Ekkehard-Schulze/precision-temperature-logger/hardware_sensor_breakout_boards/TMP117-WSON-package-Sensor-PCBs/Readme

PCBs for a TMP117 sensor
A nice alternative is the Adafruit 4821 board. See: https://www.adafruit.com/product/4821
