Ekkehard-Schulze/precision-temperature-logger/settings.txt for SD-card/settings.txt

/ This config file is for the TMP117 Adafruit Feather 32u4 Adalogger
/ Copy this file onto the logger's SD-card
/ This file requires UNIX line ends (LF). 
/ The first character of this line ('/') specifies a line as a comment.
/ A comment does not influence the logger.
/
/
/ logging interval in seconds, a multiple of this must be 3600 , 300 seconds is the default of the software. 
/
interval=300
/
/
/
/interval=6
/ use 6 seconds for test purposes, e.g. for a new sensors and setups
/ 
/ TMP117 sensor configuration
/ --------------------------------------
/ up to four TMP117 can be used on the I2C-bus
/ each sensor must be configured (wired) for its own individual I2C bus address
/ four different addresses are availabe: 0x48, 0x49, 0x4A, and 0x4B
/ these generate column names TMP1, TMP2, TMP3, TMP4
/
/ charging
/----------
/ Charge logger using a Mico-USB cable with  switch in ON position. 
/ Remove micro-SD card, if you do not want to log data during charging.
/ The yellow LED indicates charging activity. It goes dark when charging finished.
/ Charge current is 400 mA, maximal required charge time is 8 hours
/ Attention: 400 mA charge current is NOT the default charge current 
/ of the Adafruit Feather 32u4 Adalogger #2795 board!
/ You have to change R0 to 2k2 (resistor package SMD 0805) to set 
/ 400 mA charge current
