Ekkehard-Schulze/precision-temperature-logger/hardware_sensor_breakout_boards/TMP117-WSON-package-Sensor-PCBs/2022_0597_Platine_0x49_V001_SCH.PDF

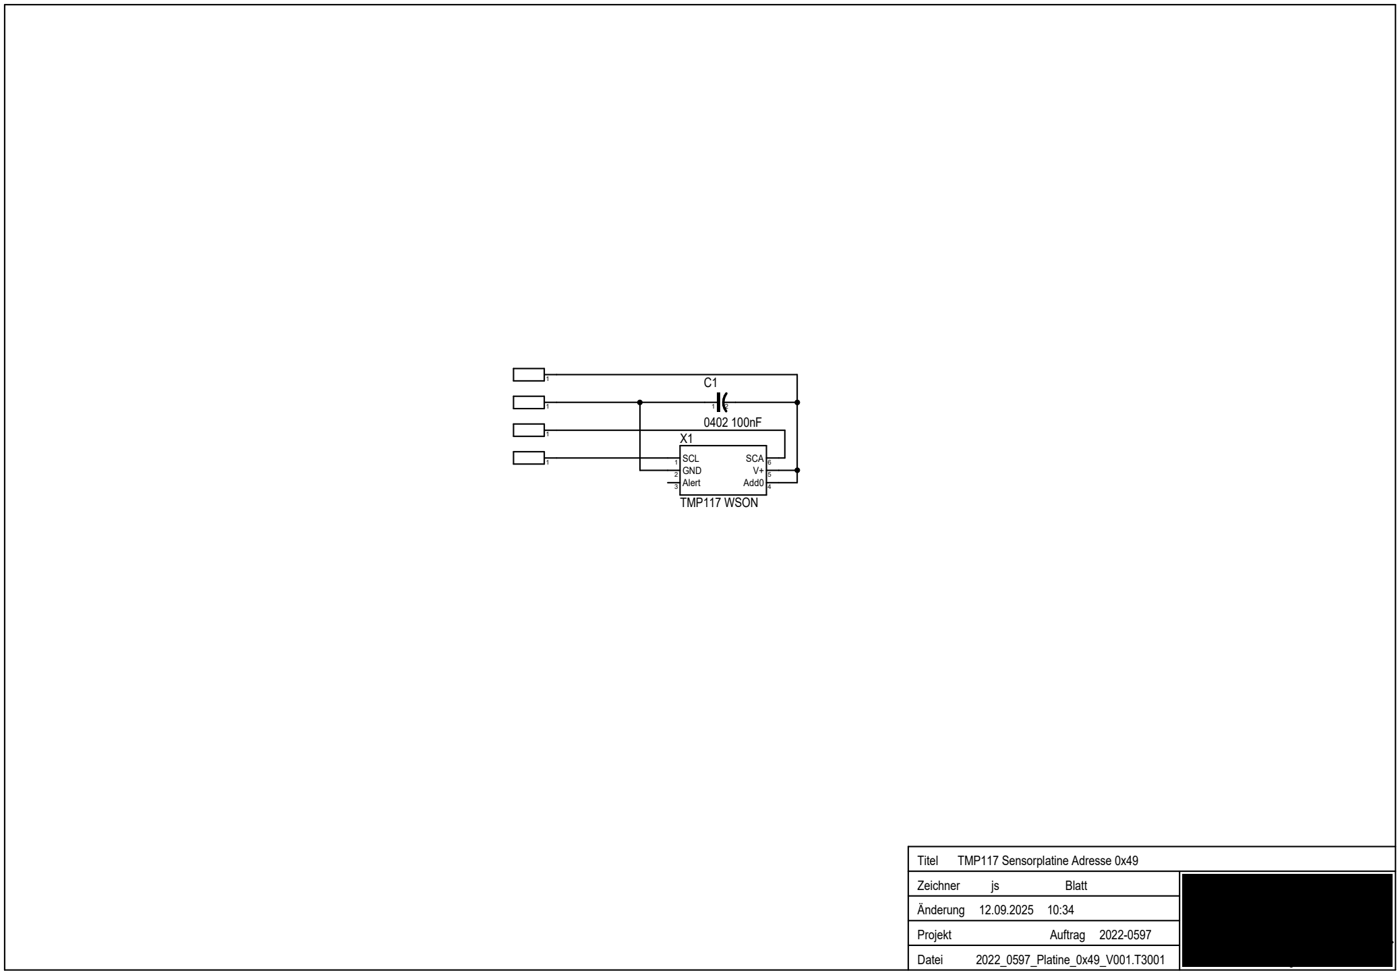
[picture p8: figure]
TMP117 Sensorplatine Adresse 0x49; 2022_0597_Platine_0x49_V001.T3001; Änderung; Projekt; Titel; Zeichner; Blatt; Datei; Institut für Biologie II/III; Albert-Ludwigs-Universität Freiburg; ATArbeitsgruppe Technik; Add0; 5 SCA; Alert ²; GND; 1 SCL TMP117 WSON

Auftrag | Schänzlestr. 1 79104 Freiburg Technischer Bereich
