Ekkehard-Schulze/precision-temperature-logger/firmware_temperature_logger_TMP117/DS3231_Set_Time.ino/README.md

Arduino firmware to set the time of the DS3231 real time clock
============================================================

Choose one of three methods:
-------

1. To set the clock to the compile time of the script, compile and upload the code in 
the Arduino IDE; the microcontroller then restarts and updates the DS3231 RTC time. 
The RTC will be a little (e.g. 1 second)
behind the real time.

2. To set a different time than the PC's system time, temporarily change
the PC's system time to the intended time, compile and run the firmware, and then change the PC's
system time back to the original. This approach can be used to set the clock for example to UTC.

3. Alternatively, to set the clock to a fixed time, uncomment line 33 and edit the time specified.
Compile and upload the software, then use an accurate reference clock to reset or startup
the microcontroller at this specific time.

Make sure the microcontroller is not started for a second time with this firmware, this 
would set a time which is behind the real time. Instead,
after setting the DS3231 RTC time, immediately upload the 
application firmware to the microcontroller.
