Ekkehard-Schulze/precision-temperature-logger/hardware_logger/Picture_2025-09-08_08h16_51.jpg

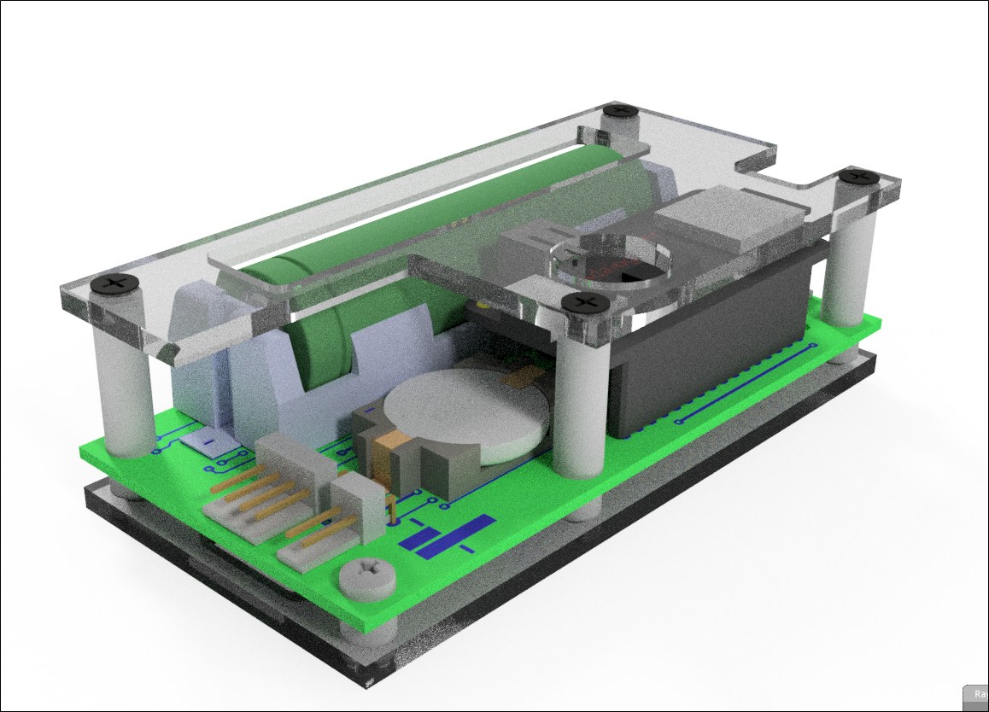
hardware_logger/Picture_2025-09-08_08h16_51.jpg
