Ekkehard-Schulze/precision-temperature-logger/hardware_logger/Picture_2025-09-08_13h42_57.png

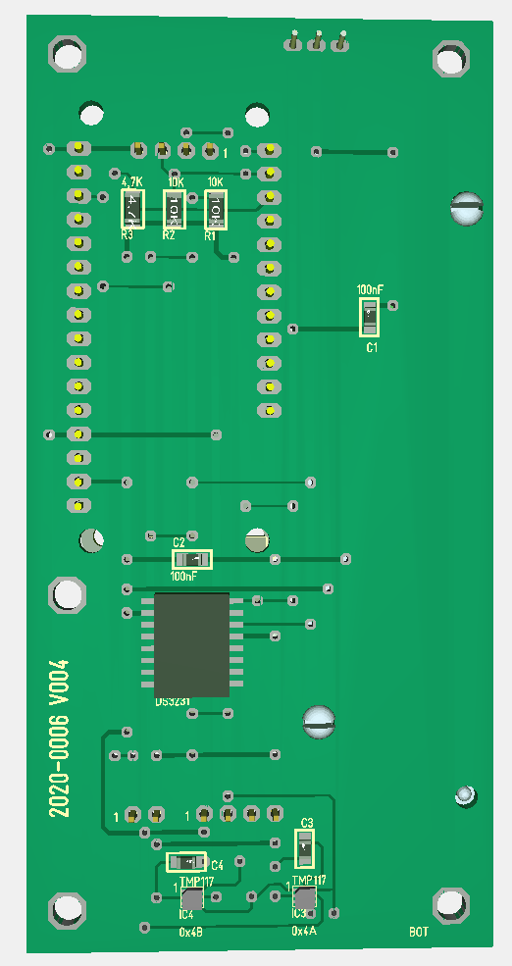
hardware_logger/Picture_2025-09-08_13h42_57.png
