Ekkehard-Schulze/precision-temperature-logger/hardware_sensor_breakout_boards/TMP117-WSON-package-Sensor-PCBs/2025-09-04_08h20_58.png

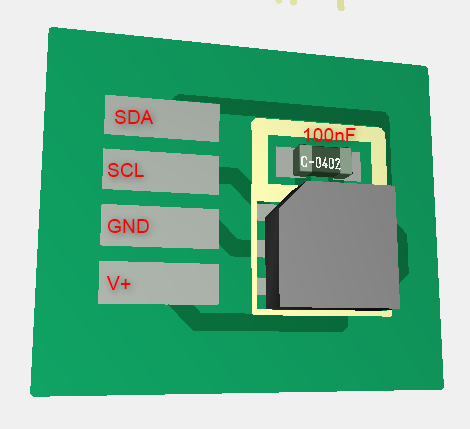
hardware_sensor_breakout_boards/TMP117-WSON-package-Sensor-PCBs/2025-09-04_08h20_58.png
