Ekkehard-Schulze/precision-temperature-logger/hardware_logger/PartsList.ods

Pos. | Beschreiburg | Hersteller | Herstellernr. | Distributor | Bestellnr. | Stück
1 | ADAFRUIT INDUSTRIESMCU, Feather 32u4 Adalogger, MCU, Entwicklungsboard, ATmega32u4 | Adafruit | 2795 | Distrelec | 301-39-090 | 1
2 | 1043 - Batteriehalter SMD 1 x 18650, Keystone | Keystone | 1043 | Distrelec | 169-14-431 | 1
3 | RND 305-00034 - Batteriehalter 1x CR2032, 20mm, SMD, RND Components | RND | RND 305-00034 | Distrelec | 301-65-960 | 1
4 | RND 305-00006 - Lithium-Knopfzellen-Batterie CR2032 5er-Pack, RND Power | RND | RND 305-00006 | Distrelec | 301-01-420 | 1
5 | Intenso MSDHC4G Micro SD Karte | Intenso |  | Reichelt | Intenso MSDHC4G | 1
6 | KEYSTONE 1042 Batteriehalter für 1 18650 | Keystone | 1042 | Reichelt | KEYSTONE 1042 | 1
7 | PSS 254/2W Printstecker, Einzelstecker, gewinkelt, 2-polig |  |  | Reichelt | PSS 254/2W | 1
8 | PSS 254/4W Printstecker, Einzelstecker, gewinkelt, 4-polig |  |  | Reichelt | PSS 254/4W | 2
9 | GP 18650 2,6 Industriezelle, Li-Ion, 18650, 3,7 V, 2600 mAh, Button Top |  |  | Reichelt | GP 18650 | 1
10 | CR 2032 Lithium-Knopfzelle, 3 V, 210 mAh, 20,0x3,2 mm Lithium-Knopfzelle, 3 V, 210 mAh, 20,0x3,2 mm FREI CR2032 |  |  | Reichelt | CR 2032 | 1
11 | ADAFRUIT INDUSTRIESMCU, Feather 32u4 Adalogger, MCU, Entwicklungsboard, ATmega32u4 | Adafruit | 2795 | RS | 124-5523 | 1
12 | KNITTER-SWITCH MMP 1010 D-1 Schiebeschalter, Einpoliger Ein/Aus-Schalter (SPST), 300 mA @ 24 V ac/dc, 500 mA @ 12 V dc | Knitter | MMP 1010 D-1 | RS | 913-9065 | 1
13 | Echtzeituhr (RTC) Batteriepufferung, Kalender, Serial-Bus Bus, SOIC 16-Pin | Maxim | DS3231SN# | RS | 732-7582 | 1
14 | TMP117AIDRVR | Texas Instruments |  | RS | 252-8571 | 2
15 | Platine 90x45 mit Stencil |  |  |  |  | 1
16 | Widerstand 1206 2 K |  |  |  |  | 2
17 | Widerstand 1206 4,7 K |  |  |  |  | 1
18 | Kondensatot 100nF 1206 |  |  |  |  | 4
19 | Buchsenleiste | Fischer Elektronik | BL1.36 G | Reichelt | FIS BL1 36 G | 2
