Ekkehard-Schulze/precision-temperature-logger/hardware_logger/LaserCut_BasePlate.pdf

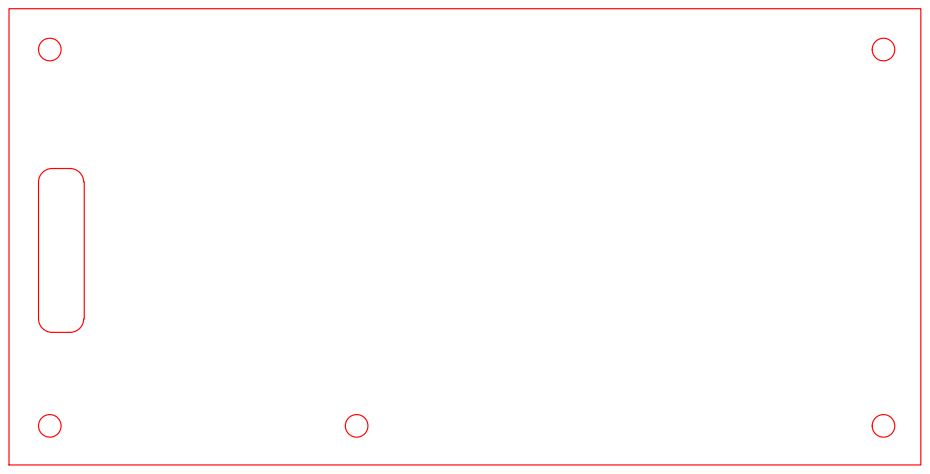
[picture p13: page 1]
3mm Acrylic glass
