Ekkehard-Schulze/precision-temperature-logger/hardware_logger/LaserCutUpperPart.pdf

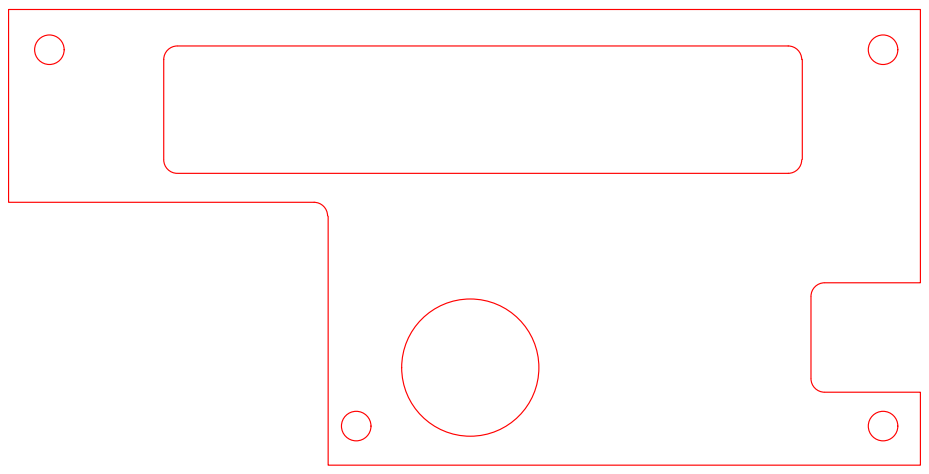
[picture p14: page 1]
3mm Acrylic glass
