Ekkehard-Schulze/precision-temperature-logger/hardware_logger/Circuit_Diagram_2020_0007_V004.PDF

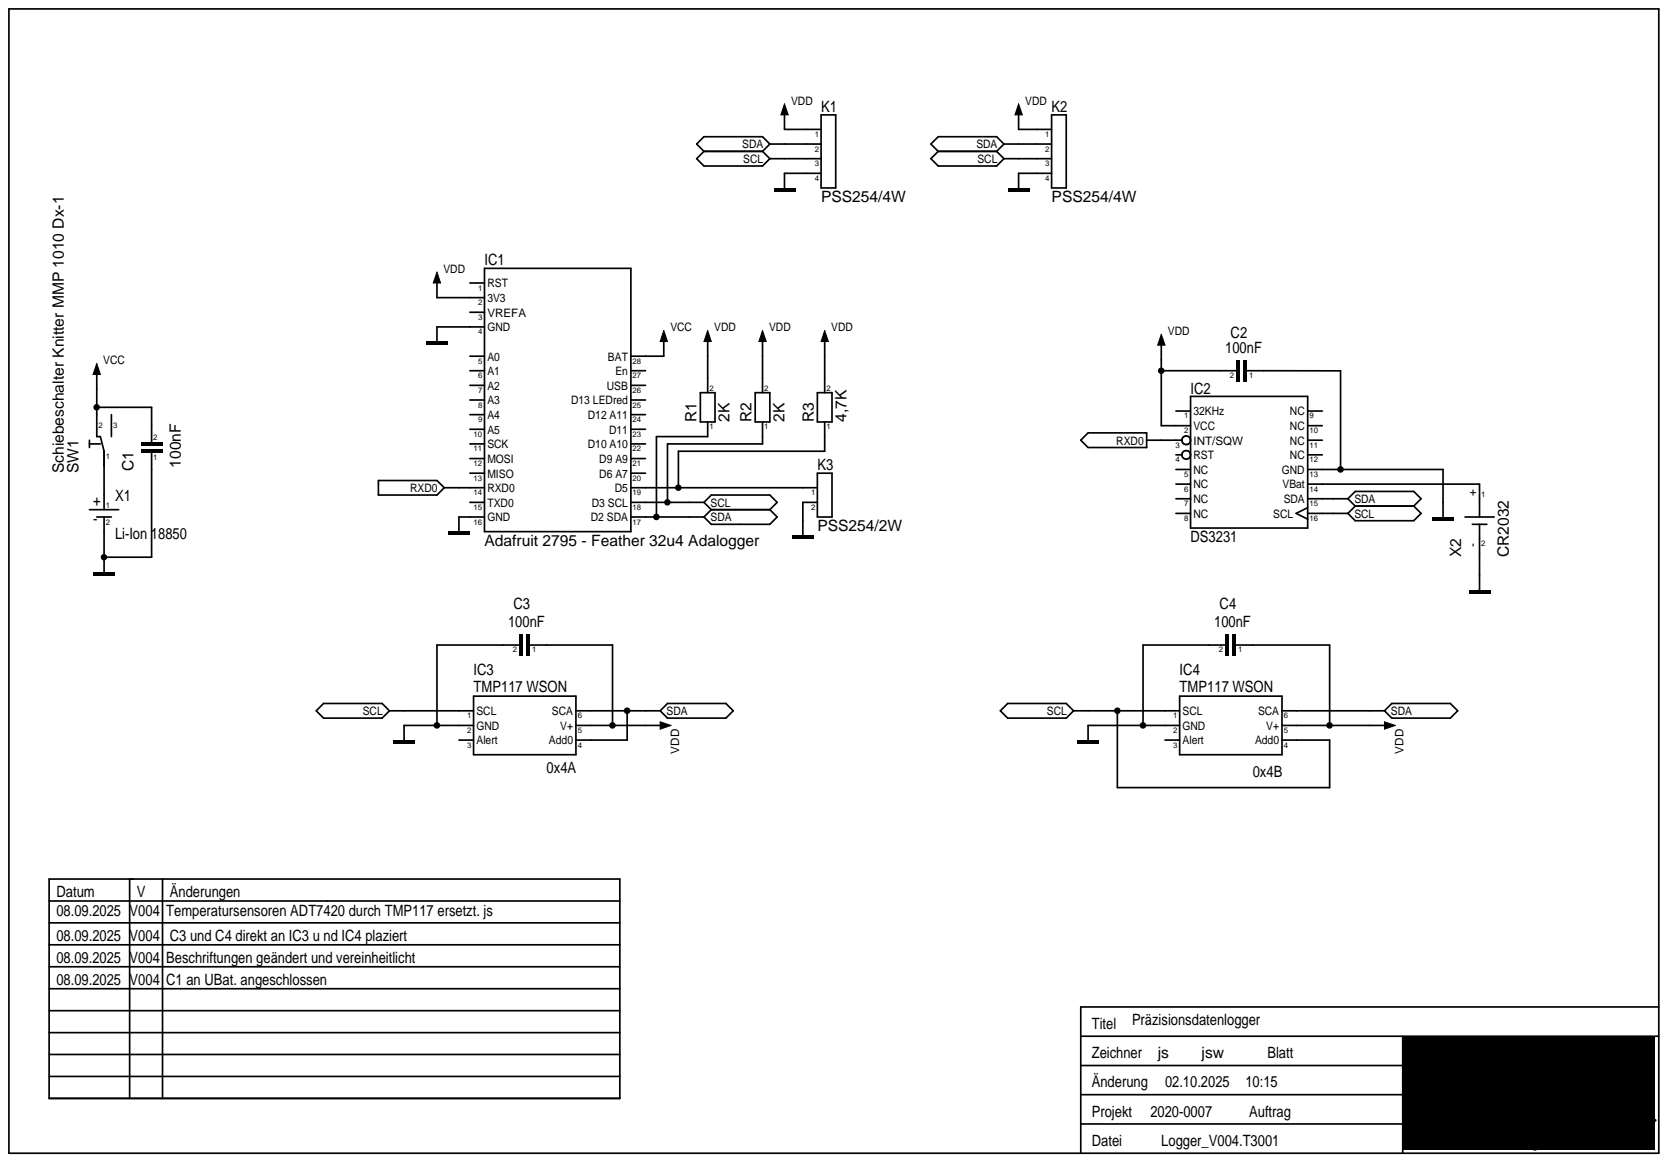
[picture p15: page 1]

Schiebeschalter Knitter MMP 1010 Dx-1

Datum | V | Änderungen
08.09.2025 | V004 | Temperatursensoren ADT7420 durch TMP117 ersetzt. js
08.09.2025 | V004 | C3 und C4 direkt an IC3 u nd IC4 plaziert
08.09.2025 | V004 | Beschriftungen geändert und vereinheitlicht
08.09.2025 | V004 | C1 an UBat. angeschlossen

Albert-Ludwigs-Universität Freiburg

Institut für Biologie II/III
Technischer Bereich
