Ekkehard-Schulze/precision-temperature-logger/hardware_logger/Drawing_01-01-2020-0007-BasePlate.pdf

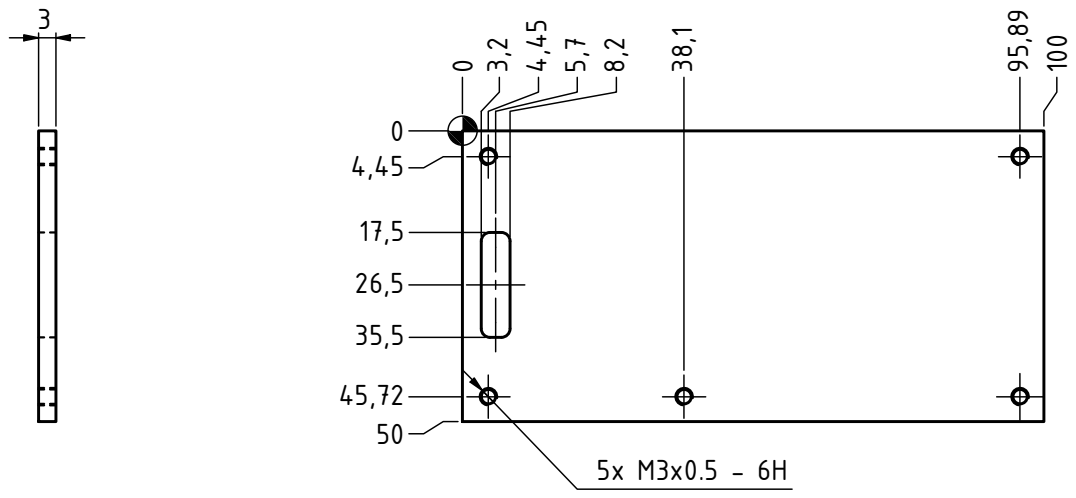
[picture p16: page 1]
