Ekkehard-Schulze/precision-temperature-logger/hardware_logger/Drawing_01-02-2020-0007-UpperPart.pdf

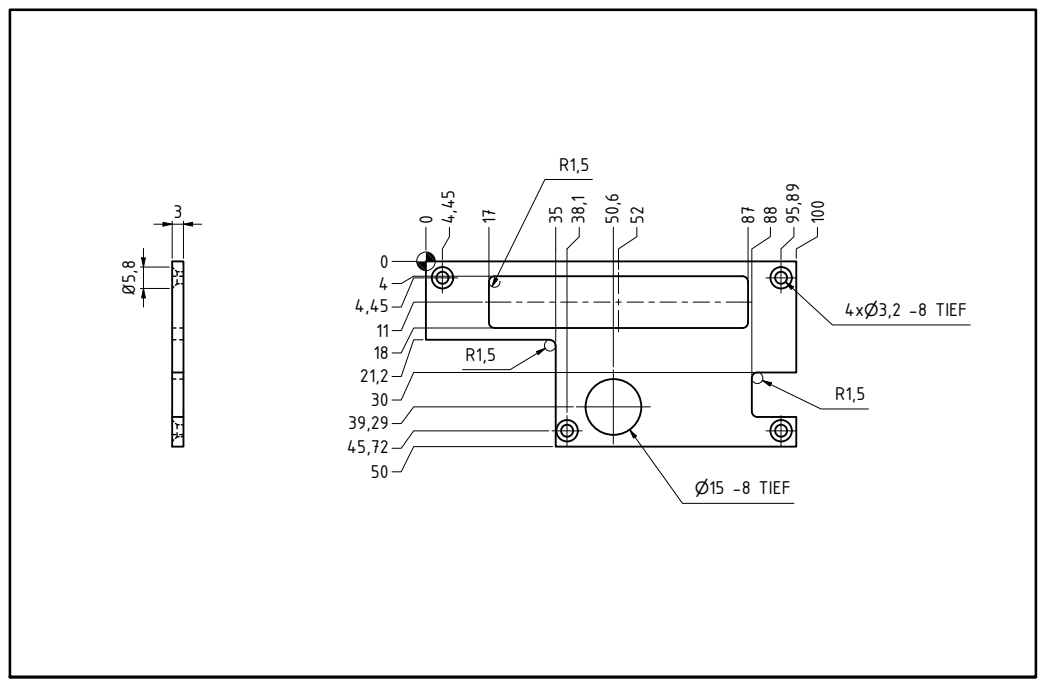
[picture p17: page 1]
