Ekkehard-Schulze/precision-temperature-logger/(commit log)

2025-12-03 precison temperature logger using ATmega and TMP117
    logger used for lboratory purposes
    [2025-12-03T08_15_00_statistics_TEMP_LOG_demo_data.TSV, PartsList.ods, TEMP_LOG_demo_data.TSV]
2025-12-04 dir renamed
    [2025-12-03T08_15_00_statistics_TEMP_LOG_demo_data.TSV, TEMP_LOG_demo_data.TSV]
2025-12-05 column names changed
    [TEMP_LOG_demo_data.TSV]
2025-12-05 tsv field named changed
    [TEMP_LOG_demo_data.TSV]
2025-12-05 py output moved to separate dir
    [2025-12-03 08_15_00_TEMP_LOG_demo_data.ods, 2025-12-03 08_15_00_TEMP_LOG_demo_data.xlsx, 2025-12-03 08_15_00_statistics_TEMP_LOG_demo_data.TSV, 2025-12-03T08_15_00_statistics_TEMP_LOG_demo_data.TSV]
2025-12-05 plotting script revised, empty last column removed
    [2025-12-03 08_15_00_TEMP_LOG_demo_data.ods, 2025-12-03 08_15_00_TEMP_LOG_demo_data.xlsx, 2025-12-03 08_15_00_statistics_TEMP_LOG_demo_data.TSV, 2025-12-03 08_15_00_statistics_TEMP_LOG_demo_data.xlsx, TEMP_LOG_demo_data.TSV]
2025-12-06 Readme provided, demo files updated
    [2025-12-03 08_15_00_TEMP_LOG_demo_data.ods, 2025-12-03 08_15_00_TEMP_LOG_demo_data.xlsx, 2025-12-03 08_15_00_statistics_TEMP_LOG_demo_data.xlsx]
2025-12-06 typos corrected
    [2025-12-03 08_15_00_TEMP_LOG_demo_data.ods, 2025-12-03 08_15_00_TEMP_LOG_demo_data.xlsx, 2025-12-03 08_15_00_statistics_TEMP_LOG_demo_data.xlsx]
2025-12-08 Update Intructions for temperature logger usage.pdf
2025-12-13 stat script changed
    [2025-12-03 08_15_00_TEMP_LOG_demo_data.ods, 2025-12-03 08_15_00_TEMP_LOG_demo_data.xlsx, 2025-12-03 08_15_00_statistics_TEMP_LOG_demo_data.xlsx]
2025-12-17 plotting tool improved for timezone info
    [2025-12-03 08_15_00_TEMP_LOG_demo_data.ods, 2025-12-03 08_15_00_TEMP_LOG_demo_data.xlsx, 2025-12-03 08_15_00_statistics_TEMP_LOG_demo_data.xlsx]
2025-12-19 milti-sensor firmware added
2025-12-19 name revised
    [xTEMP_LOG_demo_data.TSV]
2026-01-01 Openlog board updated
2026-01-01 Openlog 8 MHz 3.3V advice
2026-01-02 board links added to source
2026-02-25 screenshot added
    [2025-12-03 08_15_00_TEMP_LOG_demo_data.ods, 2025-12-03 08_15_00_TEMP_LOG_demo_data.xlsx, 2025-12-03 08_15_00_statistics_TEMP_LOG_demo_data.xlsx]
2026-02-25 image addes
    [2025-12-03 08_15_00_TEMP_LOG_demo_data.ods, 2025-12-03 08_15_00_TEMP_LOG_demo_data.xlsx, 2025-12-03 08_15_00_statistics_TEMP_LOG_demo_data.xlsx]
2026-02-25 images back-dated
    [2025-12-03 08_15_00_TEMP_LOG_demo_data.ods, 2025-12-03 08_15_00_TEMP_LOG_demo_data.xlsx, 2025-12-03 08_15_00_statistics_TEMP_LOG_demo_data.xlsx]
2026-07-16 Temperature value corrected
2026-08-21 ADT7420 shutdown failure fixed
    [temperature_logger_multisensor.ino.ino]
2026-08-25 violin html output added
    [2025-12-03 08_15_00_TEMP_LOG_demo_data.ods, 2025-12-03 08_15_00_TEMP_LOG_demo_data.xlsx, 2025-12-03 08_15_00_statistics_TEMP_LOG_demo_data.xlsx]
2026-10-04 plotting and statistics tool extended
    [2025-12-03 08_15_00_TEMP_LOG_demo_data.ods, 2025-12-03 08_15_00_TEMP_LOG_demo_data.xlsx, 2025-12-03 08_15_00_statistics_TEMP_LOG_demo_data.ods, 2025-12-03 08_15_00_statistics_TEMP_LOG_demo_data.xlsx]
